aknuds1/befaco-spring-reverb/muzhack/pictures/1_spring-reverb.png

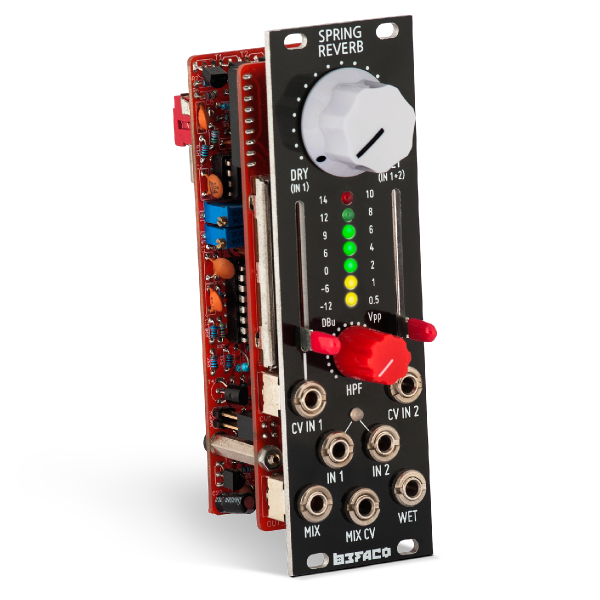
muzhack/pictures/1_spring-reverb.png
