aknuds1/befaco-spring-reverb/muzhack/pictures/2_spring-reverb-tank.png

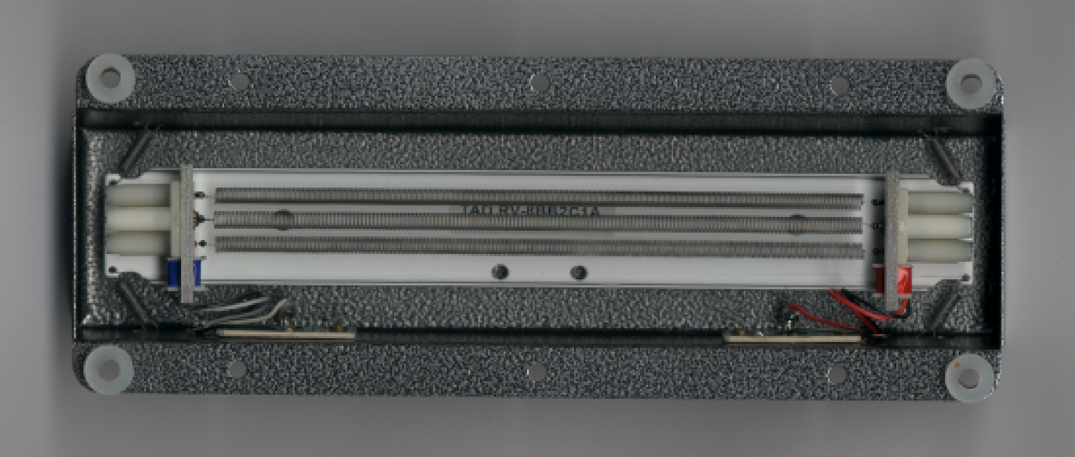
muzhack/pictures/2_spring-reverb-tank.png
