aknuds1/befaco-spring-reverb/README.md

# Befaco Rampage
Description of [Befaco Spring Reverb](https://www.befaco.org/en/spring-reverb/) DIY Eurorack
module, along with instructions for building it yourself.
