aknuds1/befaco-spring-reverb/muzhack/description.md

# DIY kit version of our voltage controlled spring reverb.

**Please note that this is an unofficial project page, the official one is [here](http://www.befaco.org/en/spring-reverb/).**

This kit has all the necessary parts to build, including front panel and power cord. It includes Minijacks by default but it is also compatible with bananas (supplied on request at the same price).

In order to permit assembly with easily available tools, all our kits come with hex nuts and not with round nuts as the assembled modules.

Reverb tank included. (8BB2A1B)
Reverb tank

More info about the module and English/Spanish assembly manual available [HERE](http://www.befaco.org/en/spring-reverb/).

By buying one of our kits you claim that you have the necessary knowledge to properly assemble and solve problems derived from it. Please, make sure you read our [shop policy](http://www.befaco.org/en/politica-de-precios/) before ordering.

If you need further technical assistance please look at our [basic troubleshooting guide](http://www.befaco.org/en/trubleshooting-questions/). If that did not help, use [our forum](http://befaco.org/forum/phpBB3/index.php) (not the email).

In case you panic and cannot make it work you can get our “Happy Ending pack” that includes technical service, parts and reshipping back to you.

Still not sure? You can get an assembled unit [here](http://www.befaco.org/en/tienda/spring-reverb/).

[!soundcloud](156301502)
[!soundcloud](156301499)
