aknuds1/befaco-spring-reverb/muzhack/files/Reverb_sch_V2.5.pdf

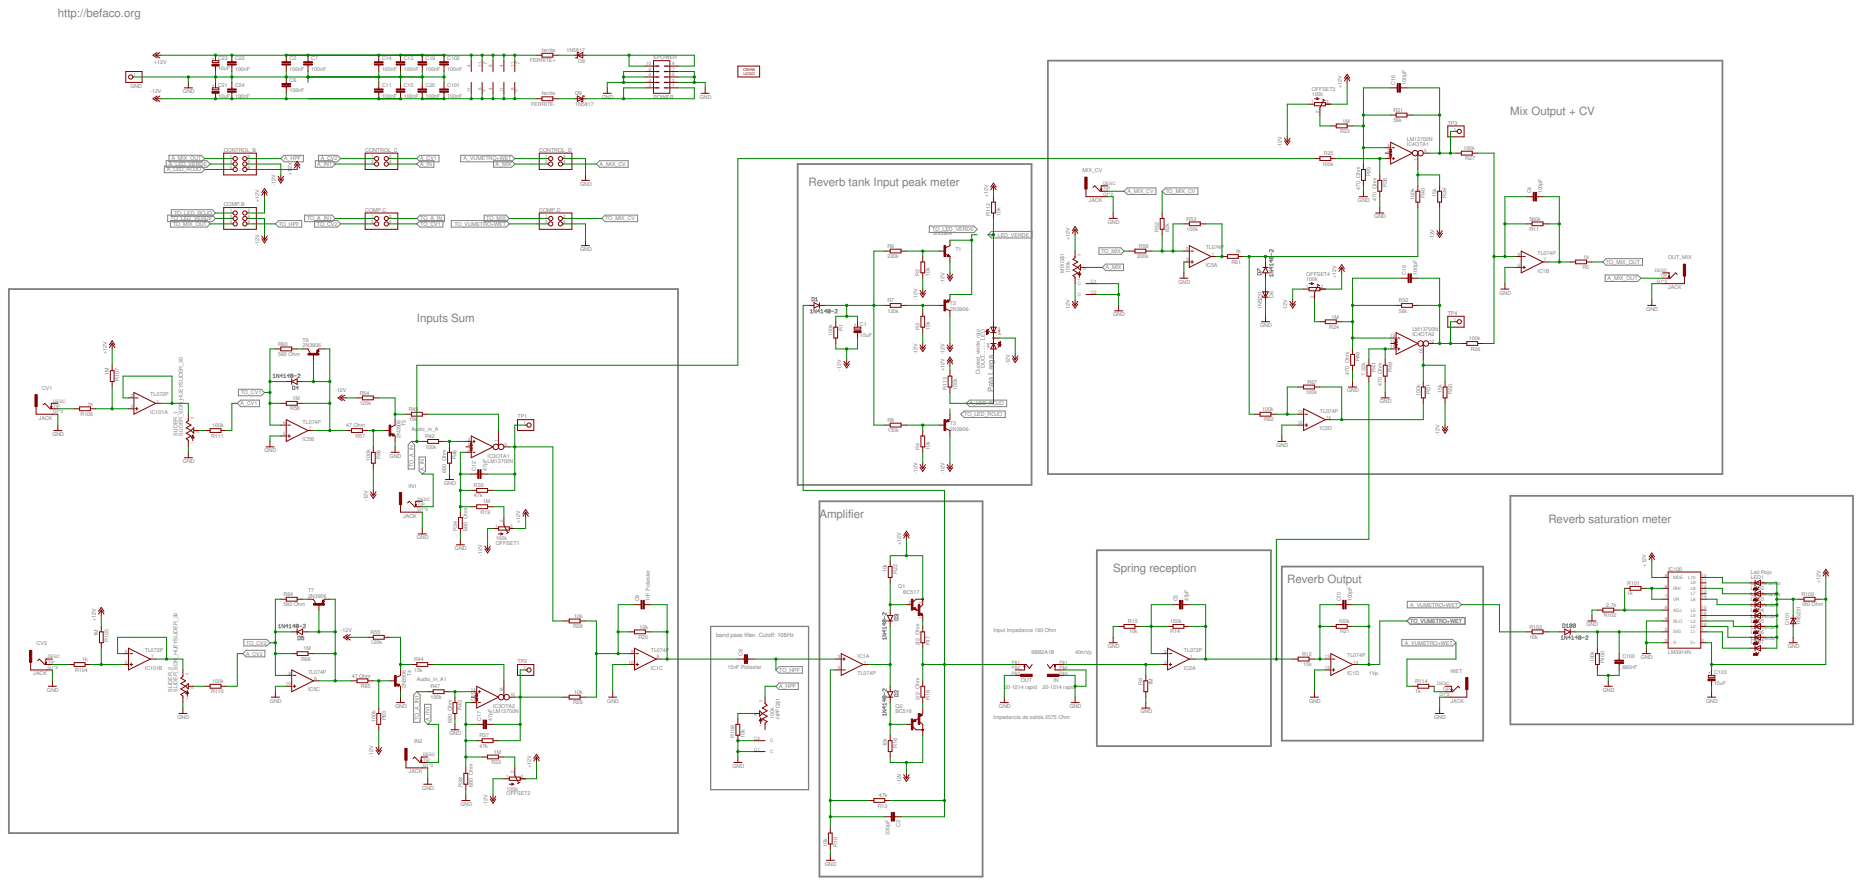
[picture p3: page 1]

Reverb tank Input peak meter

band pass filter. Cutoff: 106Hz

Impedancia de salida 2575 Ohm
